cesau78/verminology/3d-models/liquid-bait-station/latest-builds/v2.8.1-prototype/stopper.stl

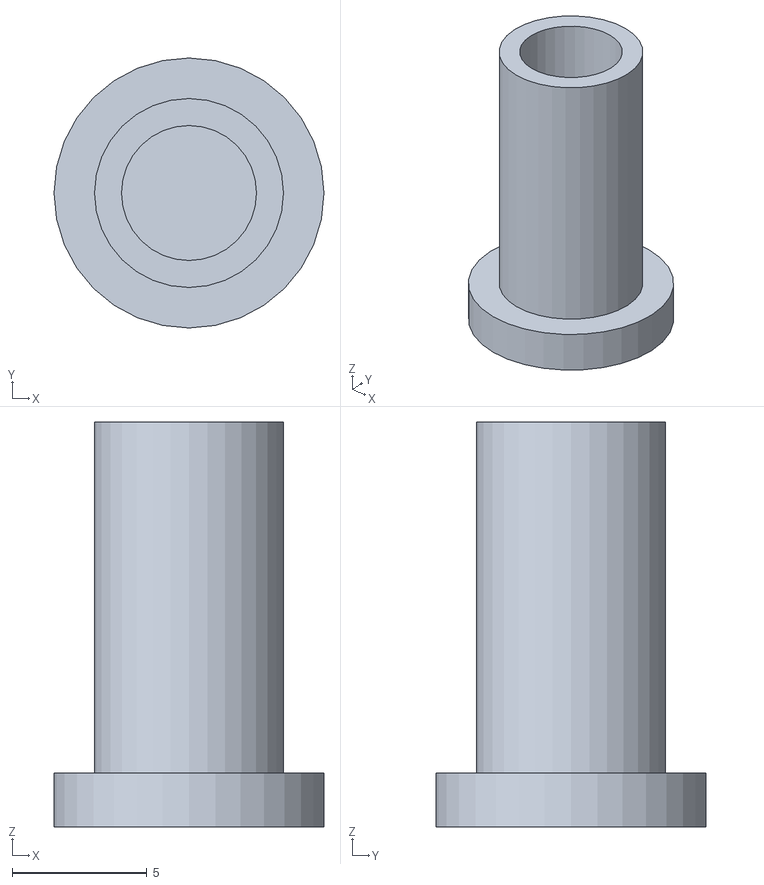
[picture p1: CAD file, 2026-07-14]
3d-models/liquid-bait-station/latest-builds/v2.8.1-prototype/stopper.stl
10.0 x 10.0 x 15.0
