cesau78/verminology/3d-models/liquid-bait-station/latest-builds/v2.8.1/station.stl

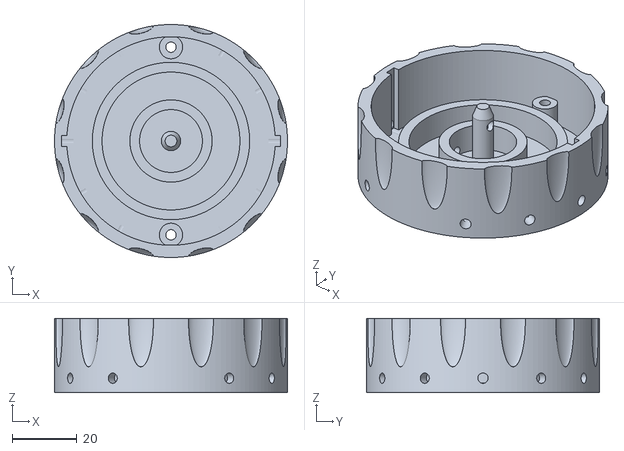
[picture p2: CAD file, 2026-07-15]
3d-models/liquid-bait-station/latest-builds/v2.8.1/station.stl
72.0 x 72.0 x 23.0
