cesau78/verminology/3d-models/liquid-bait-station/liquid-bait-station.stl

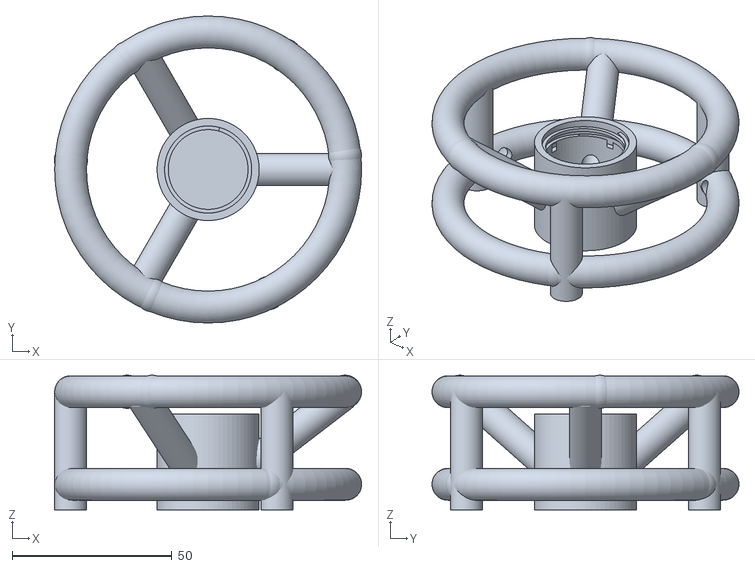
[picture p3: CAD file, 2026-02-25]
3d-models/liquid-bait-station/liquid-bait-station.stl
96.3 x 96.2 x 42.2
