cesau78/verminology/3d-models/liquid-bait-station/latest-builds/v2.8.1-prototype/grip.stl

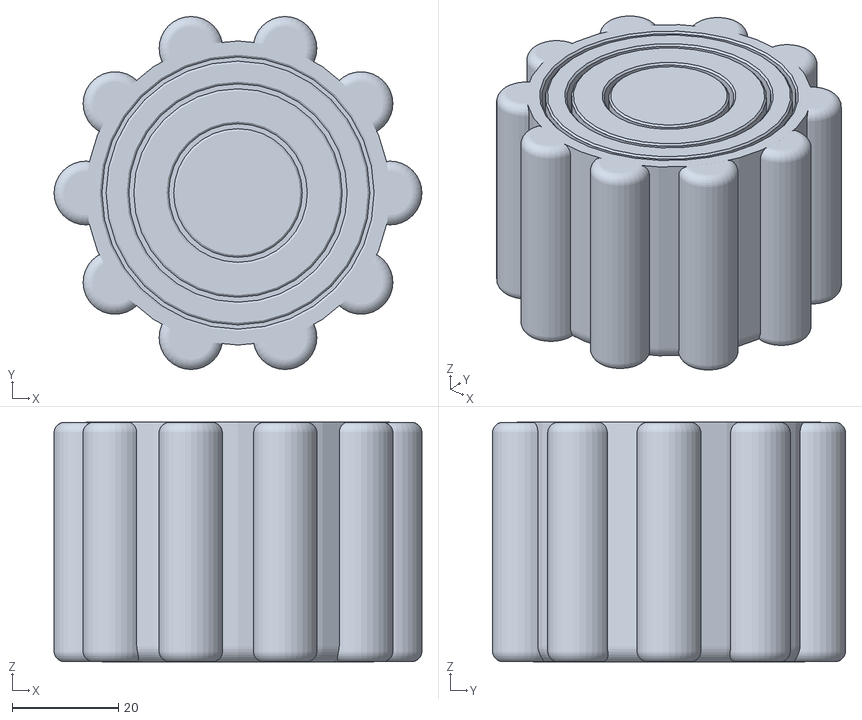
[picture p4: CAD file, 2026-07-14]
3d-models/liquid-bait-station/latest-builds/v2.8.1-prototype/grip.stl
69.1 x 66.3 x 45.0
