cesau78/verminology/3d-models/liquid-bait-station/latest-builds/v2.8.1/anvil.stl

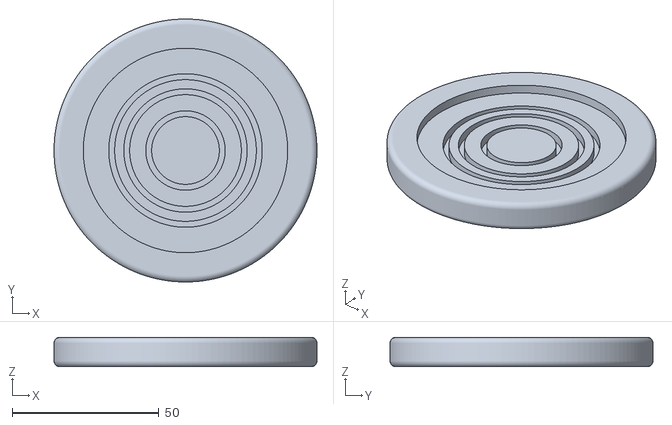
[picture p5: CAD file, 2026-07-15]
3d-models/liquid-bait-station/latest-builds/v2.8.1/anvil.stl
89.7 x 89.7 x 10.0
