cesau78/verminology/3d-models/liquid-bait-station/oring.stl

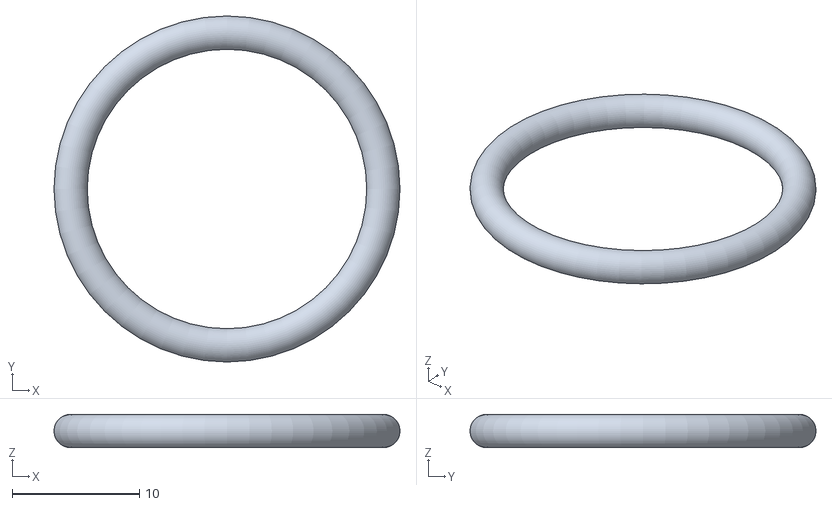
[picture p6: CAD file, 2026-02-25]
3d-models/liquid-bait-station/oring.stl
27.2 x 27.2 x 2.62
