cesau78/verminology/3d-models/liquid-bait-station/latest-builds/v2.8.1-prototype/needle-seal.stl

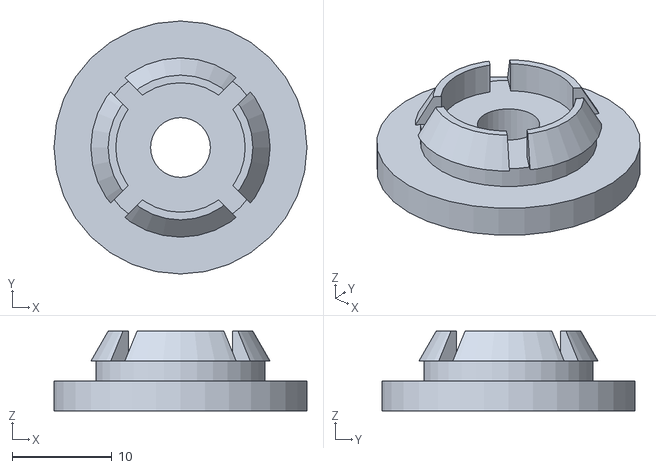
[picture p7: CAD file, 2026-07-14]
3d-models/liquid-bait-station/latest-builds/v2.8.1-prototype/needle-seal.stl
25.4 x 25.4 x 8.00
