cesau78/verminology/3d-models/liquid-bait-station/latest-builds/v2.8.1/seal-ring.stl

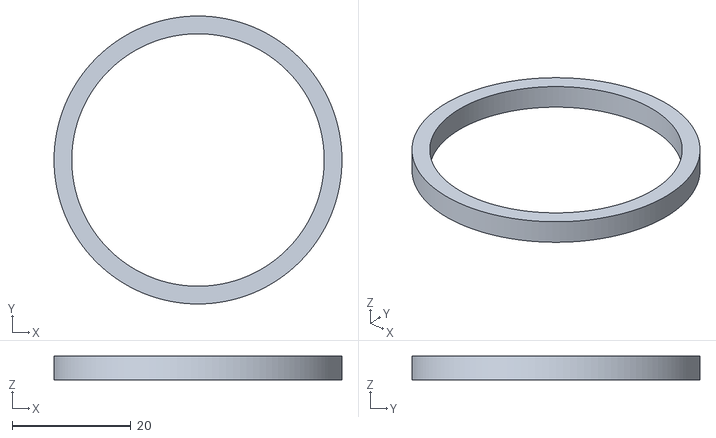
[picture p8: CAD file, 2026-07-15]
3d-models/liquid-bait-station/latest-builds/v2.8.1/seal-ring.stl
48.6 x 48.6 x 4.00
