cesau78/verminology/3d-models/liquid-bait-station/latest-builds/v2.8.1-prototype/reservoir.stl

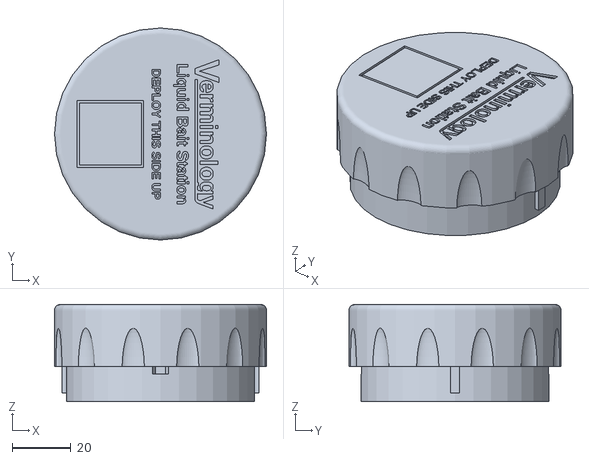
[picture p10: CAD file, 2026-07-14]
3d-models/liquid-bait-station/latest-builds/v2.8.1-prototype/reservoir.stl
72.0 x 72.0 x 33.0
