cesau78/verminology/3d-models/liquid-bait-station/latest-builds/v2.4.0-prototype/needle-seal.stl

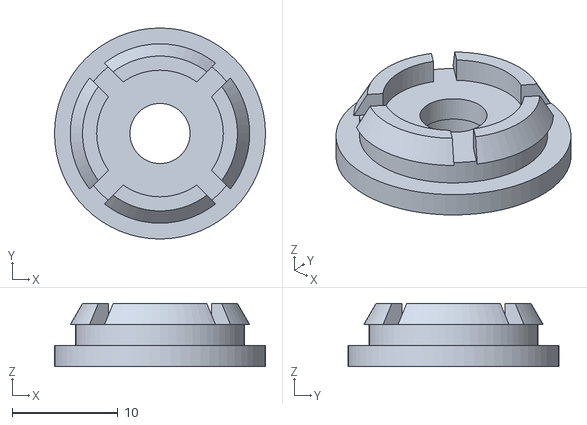
[picture p11: CAD file, 2026-04-04, an earlier design]
3d-models/liquid-bait-station/latest-builds/v2.4.0-prototype/needle-seal.stl
20.0 x 20.0 x 6.00
