cesau78/verminology/3d-models/liquid-bait-station/latest-builds/v2.4.1-prototype/needle-insert.stl

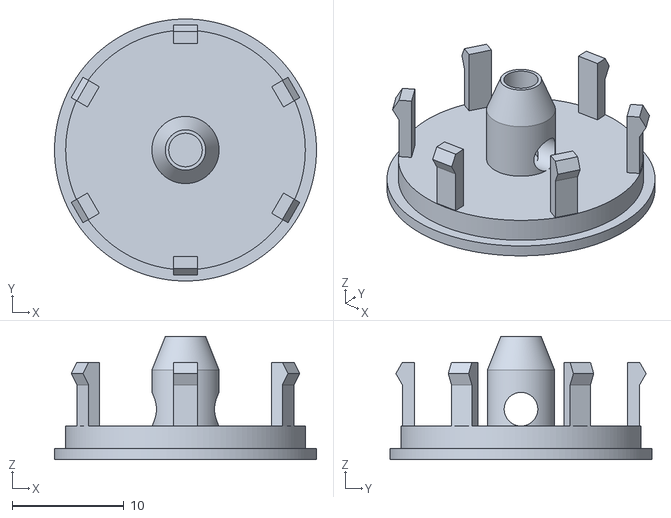
[picture p12: CAD file, 2026-04-04, an earlier design]
3d-models/liquid-bait-station/latest-builds/v2.4.1-prototype/needle-insert.stl
23.4 x 23.4 x 11.0
