cesau78/verminology/3d-models/liquid-bait-station/latest-builds/v2.5.0/station.stl

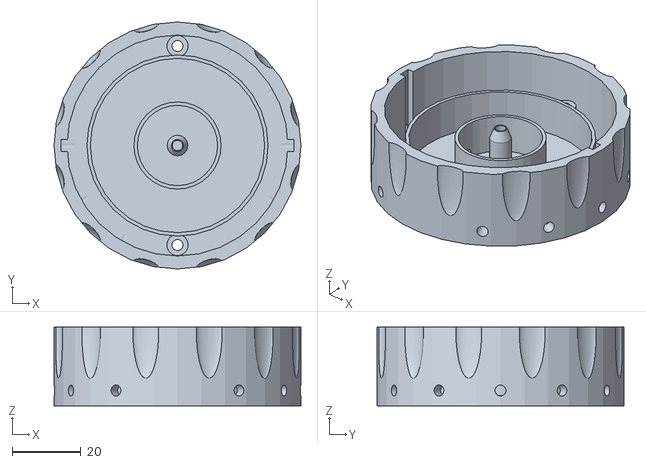
[picture p13: CAD file, 2026-04-09, an earlier design]
3d-models/liquid-bait-station/latest-builds/v2.5.0/station.stl
72.0 x 72.0 x 23.0
