cesau78/verminology/3d-models/liquid-bait-station/build-stamp.scad

// AUTO-GENERATED by scripts/Export-OpenScadStl.ps1 - do not edit by hand
// Source: build-config.json

info_stamp_line1 = "Verminology";
info_stamp_line2 = "Liquid Bait Station";
info_stamp_line3 = "v2.8.1 Prototype";
needle_seal_stamp_bottom = false;
seal_ring_stamp_bottom = false;
reservoir_stamp_bottom = true;
station_stamp_bottom = true;
stopper_stamp_bottom = false;
grip_stamp_bottom = false;
anvil_stamp_bottom = false;
