cesau78/verminology/3d-models/liquid-bait-station/v2-clam-shell/assembly.scad

// V2 Assembly View — All parts in operating position.
// Tray bait fill is the `show_batting` ring (assembly preview only — not a tread mesh). For prayer-sole tread + bracket preview see tektonology/3d-models/bumper-bracket/assembly.scad.
// Toggle 'locked' to see seated vs raised.
// Toggle 'exploded' to spread parts for inspection.

use <station.scad>
use <reservoir.scad>
use <needle-seal.scad>
use <seal-ring.scad>
use <stopper.scad>
include <common.scad>

// ── Settings ──────────────────────────────────────────────────────
exploded   = true;  // spread parts vertically for inspection
explode_gap = 2;    // mm half-offset each way when exploded (station −Z, cup +Z → 2× gap)
show_valve     = true;   // show the TPU needle seal (reservoir floor)
show_seal_ring = true;   // show the TPU barrier seal ring (reservoir bottom)
show_stopper   = true;   // show flow stopper + spring inside reservoir
show_batting   = true;   // show bait ring in tray (assembly preview only)
locked     = true;   // true = locked (pin engaged), false = unlocked (resting)

// Bait / batting — assembly depiction only (not a printed part)
batting_od_in = 2;
batting_id_in = 1;
batting_h_in  = 1 / 4;
batting_od    = batting_od_in * 25.4;
batting_id    = batting_id_in * 25.4;
batting_h     = batting_h_in * 25.4;

// ── Positions ─────────────────────────────────────────────────────
// Reservoir slides straight down; locked = fully seated, unlocked = raised.
// Exploded: reservoir stack +`explode_gap`, station/needle −`explode_gap` → 2× separation.
station_explode_z = exploded ? -explode_gap : 0;
res_z = locked
    ? reservoir_seat
    : reservoir_seat + 15;
res_z_final = res_z + (exploded ? explode_gap : 0);

// ── Valve position (shared by flange and disk) ──────────────────
valve_z = res_z_final - valve_flange_h;

// ── Stopper position ─────────────────────────────────────────────
// Locked: bottom face on needle tip (`pin_top` with station at z=0; follows `station_explode_z`).
// Unlocked: bottom ≈ reservoir outer bottom; +`explode_gap` when exploded with the cup.
stopper_z_final = locked
    ? pin_top + station_explode_z
    : res_z + (exploded ? explode_gap : 0);

// ── Assembly ──────────────────────────────────────────────────────
crosssection(station_od * 2) {
    // Station shell with integrated needle pin
    color("SlateGray", 0.8)
        translate([0, 0, station_explode_z])
            bait_station();

    // Bait ring on tray floor (visualization)
    if (show_batting)
        color("Peru", 0.9)
            translate([0, 0, station_floor + station_explode_z])
                difference() {
                    cylinder(h = batting_h, d = batting_od);
                    translate([0, 0, -0.02])
                        cylinder(h = batting_h + 0.04, d = batting_id);
                }

    // Reservoir — drops straight into station bore
    color("SteelBlue", 0.8)
        translate([0, 0, res_z_final])
            reservoir();

    // Needle seal — flange, disk, and retention ring
    if (show_valve)
        color("LimeGreen", 0.9)
            translate([0, 0, valve_z])
                needle_seal();

    // Barrier seal ring — TPU ring on reservoir bottom face
    if (show_seal_ring)
        color("LimeGreen", 0.9)
            translate([0, 0, res_z_final - seal_ring_protrusion])
                seal_ring();

    // Flow stopper piston
    if (show_stopper)
        color("OrangeRed", 0.9)
            translate([0, 0, stopper_z_final])
                stopper();

    // Compression spring (visualization cylinder)
    if (show_stopper) {
        _spr_bot = stopper_z_final + stopper_h - stopper_bore_depth;
        _spr_ceil = res_z_final + wall + spring_housing_bottom_clearance
                    + spring_housing_bore_h;
        _spr_h   = min(spring_height, _spr_ceil - _spr_bot);
        if (_spr_h > 0)
            color("Silver", 0.6)
                translate([0, 0, _spr_bot])
                    cylinder(h = _spr_h, d = spring_od);
    }
}
