cesau78/verminology/(list of files, cad)

Other CAD files:
3d-models/liquid-bait-station/latest-builds/v2.8.1-prototype/station.stl
3d-models/liquid-bait-station/latest-builds/v2.8.1/stopper.stl
3d-models/liquid-bait-station/latest-builds/v2.8.1-prototype/anvil.stl
3d-models/liquid-bait-station/latest-builds/v2.8.1-prototype/seal-ring.stl
3d-models/liquid-bait-station/latest-builds/v2.5.0-prototype/needle-seal.stl
3d-models/liquid-bait-station/stamp_generated.scad
3d-models/liquid-bait-station/latest-builds/v2.4.0-prototype/needle-gasket.stl
3d-models/liquid-bait-station/latest-builds/v2.4.0-prototype/needle-insert.stl
3d-models/liquid-bait-station/latest-builds/v2.4.1-prototype/needle-seal.stl
3d-models/liquid-bait-station/latest-builds/v2.5.0/needle-seal.stl
3d-models/liquid-bait-station/latest-builds/v2.5.1/needle-seal.stl
3d-models/liquid-bait-station/latest-builds/v2.5.2-prototype/needle-seal.stl
3d-models/liquid-bait-station/latest-builds/v2.5.2-prototype/reservoir.stl
3d-models/liquid-bait-station/latest-builds/v2.5.2-prototype/station.stl
3d-models/liquid-bait-station/latest-builds/v2.5.2/needle-seal.stl
3d-models/liquid-bait-station/latest-builds/v2.5.3-prototype/needle-seal.stl
3d-models/liquid-bait-station/latest-builds/v2.5.3-prototype/reservoir.stl
3d-models/liquid-bait-station/latest-builds/v2.5.3-prototype/station.stl
3d-models/liquid-bait-station/latest-builds/v2.5.3/needle-seal.stl
3d-models/liquid-bait-station/latest-builds/v2.6.0-prototype/anvil.stl
3d-models/liquid-bait-station/latest-builds/v2.6.0-prototype/grip.stl
3d-models/liquid-bait-station/latest-builds/v2.6.0-prototype/needle-seal.stl
3d-models/liquid-bait-station/latest-builds/v2.6.0-prototype/reservoir.stl
3d-models/liquid-bait-station/latest-builds/v2.6.0-prototype/station.stl
3d-models/liquid-bait-station/latest-builds/v2.6.0/needle-seal.stl
3d-models/liquid-bait-station/latest-builds/v2.7.0-prototype/anvil.stl
3d-models/liquid-bait-station/latest-builds/v2.7.0-prototype/grip.stl
3d-models/liquid-bait-station/latest-builds/v2.7.0-prototype/needle-seal.stl
3d-models/liquid-bait-station/latest-builds/v2.7.0-prototype/reservoir.stl
3d-models/liquid-bait-station/latest-builds/v2.7.0-prototype/station.stl
3d-models/liquid-bait-station/latest-builds/v2.7.0-prototype/stopper.stl
3d-models/liquid-bait-station/latest-builds/v2.7.0/anvil.stl
3d-models/liquid-bait-station/latest-builds/v2.7.0/needle-seal.stl
3d-models/liquid-bait-station/latest-builds/v2.7.0/stopper.stl
3d-models/liquid-bait-station/latest-builds/v2.7.1-prototype/anvil.stl
3d-models/liquid-bait-station/latest-builds/v2.7.1-prototype/grip.stl
3d-models/liquid-bait-station/latest-builds/v2.7.1-prototype/needle-seal.stl
3d-models/liquid-bait-station/latest-builds/v2.7.1-prototype/reservoir.stl
3d-models/liquid-bait-station/latest-builds/v2.7.1-prototype/station.stl
3d-models/liquid-bait-station/latest-builds/v2.7.1-prototype/stopper.stl
3d-models/liquid-bait-station/latest-builds/v2.7.1/needle-seal.stl
3d-models/liquid-bait-station/latest-builds/v2.7.1/stopper.stl
3d-models/liquid-bait-station/latest-builds/v2.7.2-prototype/anvil.stl
3d-models/liquid-bait-station/latest-builds/v2.7.2-prototype/grip.stl
3d-models/liquid-bait-station/latest-builds/v2.7.2-prototype/needle-seal.stl
3d-models/liquid-bait-station/latest-builds/v2.7.2-prototype/reservoir.stl
3d-models/liquid-bait-station/latest-builds/v2.7.2-prototype/station.stl
3d-models/liquid-bait-station/latest-builds/v2.7.2-prototype/stopper.stl
3d-models/liquid-bait-station/latest-builds/v2.7.3-prototype/anvil.stl
3d-models/liquid-bait-station/latest-builds/v2.7.3-prototype/grip.stl
3d-models/liquid-bait-station/latest-builds/v2.7.3-prototype/needle-seal.stl
3d-models/liquid-bait-station/latest-builds/v2.7.3-prototype/reservoir.stl
3d-models/liquid-bait-station/latest-builds/v2.7.3-prototype/station.stl
3d-models/liquid-bait-station/latest-builds/v2.7.3-prototype/stopper.stl
3d-models/liquid-bait-station/latest-builds/v2.7.3/needle-seal.stl
3d-models/liquid-bait-station/latest-builds/v2.7.3/stopper.stl
3d-models/liquid-bait-station/latest-builds/v2.8.0-prototype/anvil.stl
3d-models/liquid-bait-station/latest-builds/v2.8.0-prototype/grip.stl
3d-models/liquid-bait-station/latest-builds/v2.8.0-prototype/needle-seal.stl
3d-models/liquid-bait-station/latest-builds/v2.8.0-prototype/reservoir-000-e68430aa-ead2-47cb-a828-862537ad68ba-background.stl
3d-models/liquid-bait-station/latest-builds/v2.8.0-prototype/reservoir-000-e68430aa-ead2-47cb-a828-862537ad68ba-contrast.stl
3d-models/liquid-bait-station/latest-builds/v2.8.0-prototype/reservoir-text.stl
3d-models/liquid-bait-station/latest-builds/v2.8.0-prototype/reservoir.stl
3d-models/liquid-bait-station/latest-builds/v2.8.0-prototype/seal-ring.stl
3d-models/liquid-bait-station/latest-builds/v2.8.0-prototype/station-text.stl
3d-models/liquid-bait-station/latest-builds/v2.8.0-prototype/station.stl
3d-models/liquid-bait-station/latest-builds/v2.8.0-prototype/stopper.stl
3d-models/liquid-bait-station/latest-builds/v2.8.0/anvil.stl
3d-models/liquid-bait-station/latest-builds/v2.8.0/needle-seal.stl
3d-models/liquid-bait-station/latest-builds/v2.8.0/reservoir-text.stl
3d-models/liquid-bait-station/latest-builds/v2.8.0/seal-ring.stl
3d-models/liquid-bait-station/latest-builds/v2.8.0/station-text.stl
3d-models/liquid-bait-station/latest-builds/v2.8.0/station.stl
3d-models/liquid-bait-station/latest-builds/v2.8.0/stopper.stl
3d-models/liquid-bait-station/v1-double-torus/liquid-bait-station.scad
3d-models/liquid-bait-station/v1-double-torus/oring.scad
3d-models/liquid-bait-station/v2-slit-valve/reservoir.stl
3d-models/liquid-bait-station/v2-slit-valve/station.stl
