cesau78/verminology/3d-models/liquid-bait-station/latest-builds/v2.5.0/release-notes.md

# v2.5.0 — Production Build

**Date:** Apr 8, 2026

Production-quality STL export of v2.5.0 at `$fn = 128`. Same geometry as
`v2.5.0-prototype`; version stamp reads "v2.5.0" (no Prototype suffix).

See `../v2.5.0-prototype/release-notes.md` for full design changelog.

## Artifacts

| File | Part |
|---|---|
| `reservoir.stl` | Reservoir |
| `station.stl` | Station (bottom stamp: v2.5.0) |
| `needle-seal.stl` | TPU needle seal |
