cesau78/verminology/(commit log)

2026-02-23 added services and database - wip
    [liquid-bait-station.3mf, liquid-bait-station.scad]
2026-02-23 chore: update generated STL [skip ci]
2026-02-24 reversed thread direction
    [liquid-bait-station.scad]
2026-02-24 made core a little wider
    [liquid-bait-station.scad]
2026-02-24 reduced the number or arms to 3
    [liquid-bait-station.scad]
2026-02-24 back to prod
    [liquid-bait-station.scad]
2026-02-24 performance tuning
    [liquid-bait-station.scad]
2026-02-24 reversed threads, again. make a lead-in cut for the bottle insertion
    [liquid-bait-station.scad]
2026-02-24 preview off
    [liquid-bait-station.scad]
2026-02-25 threading adjustments and o-ring inclusing
    [liquid-bait-station.3mf, liquid-bait-station.scad, oring.scad]
2026-02-25 disconnected base height from torus height - increasd difference by 10mm
    [liquid-bait-station.scad]
2026-02-25 adjusted backstops and flows
    [liquid-bait-station.scad]
2026-02-25 adjusted rendering issue
    [liquid-bait-station.scad]
2026-02-25 adjusting backstop size
    [liquid-bait-station.scad]
2026-02-25 added circular groove for oring
    [liquid-bait-station.3mf, liquid-bait-station.scad, liquid-bait-station.stl]
2026-02-25 oring adjustments
    [liquid-bait-station.3mf, liquid-bait-station.scad, oring.scad]
2026-02-25 latest render
    [liquid-bait-station.3mf]
2026-02-26 lowered tube arm position on the reservoir, added a lip for the oring to rest on
    [liquid-bait-station.scad]
2026-02-27 fasten parts progress check-in
    [liquid-bait-station.3mf]
2026-03-30 reorganize liquid-bait-station into v1-double-torus and v2-multi-part
    [liquid-bait-station.3mf, liquid-bait-station.scad, oring.scad]
2026-03-31 add v2-slit-valve liquid bait station: rigid reservoir with push-pin activated TPU slit valve
    Replaces the v1 bottle-based design which failed due to flexible bottles causing
    uncontrolled fluid rush. V2 uses a rigid 3D-printed reservoir (~124ml) that drops
    into an open tray station with a bayonet ramp-lock. Twisting to lock pushes the
    reservoir onto a central conical pin that spreads a TPU cross-slit valve open.
    Unlocking raises the reservoir off the pin and the valve self-seals.
    [assembly.scad, common.scad, reservoir.scad, slit-valve.scad, station.scad]
2026-03-31 v2 station: add dual grooves, hump ring, ant tunnels, blunted pin
    Redesign the bait station tray with outer groove, hump torus, and inner
    groove for better bait distribution. Reservoir raised to sit above hump
    with half-pipe ant tunnels bridging over it. Guard holes reduced to 12
    at 3mm diameter. Push pin tip blunted for safety. Internal ribs replaced
    with radial struts that clear the valve bore.
    [assembly.scad, common.scad, reservoir.scad, station.scad]
2026-03-31 v2 slit valve: add flange stop collar, pin fluid channels, fix ant tunnels
    Slit valve gets a wider flange collar (2mm larger radius) that prevents
    push-through, with a snug sliding fit replacing the press-fit bore. Pin
    gains internal fluid channels (vertical + perpendicular at drain level).
    Ant tunnels trimmed to reservoir inner wall. Assembly exploded view now
    separates the valve between station and reservoir.
    [assembly.scad, common.scad, reservoir.scad, slit-valve.scad, station.scad]
2026-03-31 v2 slit valve: lower pin cone to flange top, shorten cone, tighten seal
    Pin cone now starts where the retention flange ends, reduced from 3mm
    to 2mm tall. Flange pin hole clearance tightened to 0.05mm radius for
    watertight TPU interference fit. Drain channels shortened to inner
    torus. Assembly view color-codes pin shaft, cone, retention ring, and
    slit valve disk. TPU plug z-position corrected by flange thickness.
    [assembly.scad, common.scad, slit-valve.scad, station.scad]
2026-03-31 v2 slit valve: add solid shipping plug for transport and storage
    Same flange and disk dimensions as the slit valve but with no slits,
    sealing the reservoir for filling, transport, and storage.
    [shipping-plug.scad]
2026-03-31 v2 reservoir: add self-supporting ceiling dome, fix strut-tunnel overlap
    Gentle 3mm spherical dome on interior ceiling eliminates need for
    supports or tree structures during FDM printing (~9° max overhang).
    Reordered CSG so ant tunnel cutouts apply after struts and dome,
    preventing struts from protruding into the underside channels.
    [common.scad, reservoir.scad]
2026-03-31 v2 reservoir: fix 2-manifold warning in ceiling dome
    Add tiny epsilon offsets to dome bounding cylinder to eliminate
    zero-thickness knife edge at cavity wall and coincident face
    with ceiling plane.
    [reservoir.scad]
2026-03-31 v2: fix coincident faces, regenerate STLs, add shipping plug STL
    Epsilon overlaps on struts, bayonet lugs, and ant tunnels eliminate
    all 2-manifold warnings. All four parts render Simple: yes.
    [reservoir.scad, reservoir.stl, shipping-plug.stl, slit-valve.stl, station.stl]
2026-04-01 v2: CW bayonet lock, flush skirt, valve retainer, remove dome
    - Bayonet lock: straight vertical entry + clockwise twist (righty-tighty)
    replaces counter-clockwise ramped descent
    - Reservoir skirt: outer cylinder extends reservoir to station OD for
    flush assembled profile
    - Slit valve retainer: top retention ring with tapered OD and flow slots
    snaps valve into reservoir bore
    - Remove ceiling dome (reservoir prints hole-up, dome unnecessary)
    - Guard holes increased to 3.2mm
    [assembly.scad, common.scad, reservoir.scad, slit-valve.scad, station.scad]
2026-04-01 v2 reservoir: cone ant tunnels, aligned struts, touching geometry
    - Ant tunnels changed from half-cylinders to half-cones spanning from
    reservoir wall to just outside valve retainer ring
    - Cone base sized so adjacent cones touch at the wall
    - Cone tip is 4mm diameter (flush with floor near retainer)
    - Strut count linked to tunnel count (12), centered with each cone
    [common.scad, reservoir.scad]
2026-04-01 modifications following the first print
    [assembly.scad, common.scad, liquid-bait-station.3mf, reservoir.3mf, reservoir.stl, slit-valve.scad, slit-valve.stl, station.stl]
2026-04-02 v2: shrink to 85mm for 3×3 on 256mm plate, shorten bayonet groove
    Reduce station OD from 90→85mm and reservoir OD from 82→77mm to fit
    9 parts per 256mm build plate (3×85=255mm) instead of 4. Volume drops
    from ~124ml to ~109ml. Also shorten bayonet lock rotation from 30° to
    5° so the groove only extends as far as the drop, matching lug travel.
    [common.scad, liquid-bait-station.3mf, station.stl]
2026-04-02 v2: add radial grip scallops to reservoir top and station bottom
    Radial spoke cylinders (r=5mm) from center, angled 15° down, cutting
    1mm into the top face at the rim corner for fingertip grip during
    bayonet twist. Station has mirrored scallops on the bottom face.
    [common.scad, reservoir.scad, station.scad]
2026-04-02 v2: add 1mm grip pad, apply scallops last
    Extra 1mm material on reservoir top and station bottom so scallops
    cut into solid padding rather than the functional surfaces. Restructure
    both assemblies so scallop subtraction is the outermost operation.
    [common.scad, reservoir.scad, station.scad]
2026-04-02 v2: widen grip scallop grooves to 9mm
    Increase scallop cylinder radius from 5 to 10.625 for 9mm wide
    grooves at the same 1mm cut depth.
    [common.scad]
2026-04-02 v2: Minkowski grip pads for rounded scallop ridges
    Replace simple extruded grip pads with Minkowski'd disks (thin
    cylinder + 0.5mm sphere). Scallops cut through the rounded pad so
    ridges between grooves inherit smooth edges instead of hard corners.
    [common.scad, reservoir.scad, station.scad]
2026-04-02 latest renders
    [reservoir.stl, station.stl]
2026-04-03 add .gitignore, stop tracking 3mf files
    3mf files are slicer project files that change frequently and
    bloat the repo. STL source files are still tracked.
    [liquid-bait-station.3mf, reservoir.3mf]
2026-04-03 v2: replace top/bottom grip scallops with oval side-wall indents
    Ellipsoid indents on the outer wall span the station/reservoir joint,
    with natural taper stopping smoothly before top and bottom floors.
    Reservoir scallops pre-rotated by bayonet_rotation so they align when
    locked. Bump $fn render to 256 for smoother cylinders.
    [assembly.scad, common.scad, reservoir.scad, station.scad]
2026-04-03 v2: side-wall oval grip scallops, edge fillets, re-render STLs
    Replace top/bottom radial grip scallops with ellipsoid indents on
    the outer wall spanning the station/reservoir joint. Reservoir
    scallops pre-rotated by bayonet_rotation for alignment when locked.
    Add 2mm quarter-round edge fillets on station bottom and reservoir
    top. Revert $fn render to 64 for prototype iteration speed.
    [common.scad, reservoir.scad, station.scad]
2026-04-03 v2: replace push pin cone with open straw for fluid flow
    Remove cone/blunt cap tip, make pin a straight hollow straw open at
    top. Widen internal bore to 3mm, add 3 cross-tunnels at 120° (was 2
    at 90°) for better drainage. Pin penetration set to 3mm past valve.
    [common.scad, station.scad]
2026-04-03 v2: add needle-seal valve — slit-free TPU seal with interference fit
    [common.scad, needle-seal.scad]
2026-04-03 v2: rename v2-slit-valve to v2-clam-shell
    [assembly.scad, common.scad, needle-seal.scad, reservoir.scad, shipping-plug.scad, shipping-plug.stl, slit-valve.scad, slit-valve.stl]
2026-04-03 v2: replace bayonet twist-lock with straight tab slide-lock
    [assembly.scad, common.scad, reservoir.scad, station.scad]
2026-04-03 v2: add retention clips with snap-fit barbs, remove bottom fillet, clean up assembly
    Curved clip arms on reservoir skirt slide into grooves on station outer
    wall. Diamond-shaped barbs at 30° ramp angle snap into notches at seated
    position. Guard holes at clip positions removed. Stale pin cone/shaft
    references removed from assembly.
    [assembly.scad, common.scad, reservoir.scad, station.scad]
2026-04-03 feat(liquid-bait-station): bottom stamp, export scripts, latest-build STLs
    - Add print-stamp-config.json, stamp_generated.scad, and PS1/bash export to latest-build
    - Station bottom deboss: three lines, rule to y tail, radial shift, mesh_preview rename
    - GitHub Actions workflow for stamp regen and STL export
    - Move tracked STLs into latest-build (rename-detected where matched)
    Made-with: Cursor
    [common.scad, needle-seal.stl, reservoir.scad, shipping-plug.stl, slit-valve.stl, stamp_generated.scad, station.scad]
2026-04-03 v2 clam-shell station: flat tray, barriers, pin bore, assembly bait
    - Flat 3mm floor; remove torus grooves/drains; 6mm tray gap under reservoir
    - Outer 2in ID + inner 1in OD barrier rings; six radial ports in inner wall
    - Single lateral pin channel through full OD; no holes through outer barrier
    - Pin tip height flush with needle seal disk (not retainer)
    - Assembly view: optional bait ring; batting visualization
    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
    [assembly.scad, common.scad, station.scad]
2026-04-03 v2 station: foil-piercing frustum on push pin tip
    Outer taper (3 mm) from pin_dia to pin_tip_od; straight bore through tip.
    pin_shank_h separates cylindrical shank from taper; tunable in common.scad.
    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
    [common.scad, station.scad]
2026-04-03 v2: unit_od_reduction for smaller footprint; tray and barriers restored
    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
    [common.scad]
2026-04-03 v2 clam-shell: needle insert, center lip, and inner guide rails
    Add needle-insert-lib (include-based) with coaxial pocket and preview/export
    entry points. Insert base OD matches the inner bait barrier hole ID; station
    subtracts a matching pocket.
    Add inner-barrier guide rails and center filler, unioned after the pocket so
    they stay in the model. Add a floor annulus lip under the hole with notches on
    the hole side between rails for clip clearance; preview highlights the lip in
    red. Rails extend one millimeter below the tray floor to meet the lip.
    Update common parameters, assembly include wiring, and print-stamp config for
    the needle-insert STL export.
    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
    [assembly.scad, common.scad, needle-insert-export.scad, needle-insert-lib.scad, needle-insert.scad, stamp_generated.scad, station.scad]
2026-04-03 v2 needle insert: OD groove gasket, insert OD clearance, previews
    - Insert base OD = inner barrier hole ID - 0.2 mm; center floor lip 1 mm inset
    - Circumferential groove on base OD (2 mm tall, 1 mm deep); toroidal TPU gasket part + export
    - pin_tunnel_z vs needle seal flange; assembly/subassembly show gasket
    - print-stamp-config: needle-gasket STL export
    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
    [assembly.scad, common.scad, needle-gasket-export.scad, needle-gasket.scad, needle-insert-lib.scad, needle-insert-subassembly.scad, station.scad]
2026-04-03 v2 station/needle: drop center lip, fix channels, rail offset
    - Remove center hole floor ring, notches, and related common params; drop red lip preview color
    - Inner barrier guide rails +1 mm Z (inner_barrier_rail_z_offset_mm)
    - Lateral bore ends at inner barrier hole ID; cap pin_tunnel_z so lateral clears base top; axial bore from lateral bottom
    - needle_insert_channels: vertical from pin_channel_z_bottom, not through bed
    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
    [common.scad, needle-insert-lib.scad, station.scad]
2026-04-03 Refine v2 needle insert base and TPU ring geometry
    - Model base as two stacked cylinders (bottom 1 mm at hole ID, top 2 mm at bottom OD minus 2 mm diameter).
    - Remove OD groove; optional retention clips gated by needle_insert_retention_clips_enabled.
    - TPU ring: relaxed inner/outer radii and assembly comments; gasket OD still referenced to hole ID offset.
    - Pocket uses largest base OD; subassembly and assembly comments updated.
    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
    [assembly.scad, common.scad, needle-gasket.scad, needle-insert-lib.scad, needle-insert-subassembly.scad]
2026-04-03 v2 clam-shell: needle clips on land, barb geometry, pocket cap, subassembly station
    - Add bait_station to needle-insert-subassembly with use/station.scad; crosssection uses station_od*2.
    - Six retention posts on gasket land (not lower ring); 2 mm top barb with two ramps at configurable slope (60° from horizontal).
    - Restore inner-barrier rail filler back plate (annulus land OD to barrier ID); fix mistaken filler logic that dropped it.
    - needle_insert_pocket: radius from max(body, land+barb)+c, capped inside inner bait barrier OD minus min wall so subtract does not erase the ring.
    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
    [common.scad, needle-insert-lib.scad, needle-insert-subassembly.scad, station.scad]
2026-04-03 v2 needle clips: stem trim, radial inset, barb drop
    - Shorten stem from step bottom (stem_bottom_trim_mm) for interference fit.
    - Shift whole post+barb inward (retention_radial_inset_mm); rename from barb-only inset.
    - Lower barb base 0.2 mm (top_barb_drop_mm); stem ends at barb base; pocket z_clip follows.
    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
    [common.scad, needle-insert-lib.scad]
2026-04-04 liquid-bait-station: latest-builds + versioned STLs, drop slit valve / shipping plug
    - Replace latest-build/ with latest-builds/v2.4.0/ for v2 STLs; add releases.md.
    - print-stamp-config: product_version v2.4.0; stl paths use {product_version} placeholder.
    - Export-OpenScadStl.ps1 + export-open-scad-stl.sh substitute {product_version} in output paths.
    - CI artifact: latest-builds/**/*.stl and **/*.md.
    - Remove obsolete slit-valve.scad, shipping-plug.scad; drop slit_* params from common; refresh comments (needle seal).
    - Remove legacy latest-build STLs (oring, slit-valve, shipping-plug); stamp_generated v2.4.0 Prototype.
    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
    [assembly.scad, common.scad, needle-gasket.stl, needle-insert.stl, needle-seal.scad, needle-seal.stl, reservoir.scad, shipping-plug.scad]
2026-04-04 liquid-bait-station: fn 128 mesh export, prototype vs production STL folders
    - common.scad: mesh export fn 64 -> 128 when mesh_preview=false.
    - Rename latest-builds/v2.4.0 -> v2.4.0-prototype; config uses {version_folder}.
    - Export scripts: default output ...-prototype and Prototype stamp from preview;
    LBS_PRODUCTION=1 -> latest-builds/<version>/ only, no Prototype stamp.
    - Add workflow_dispatch production STL workflow (verify_product_version optional).
    - Rename stamp-export workflow title to prototype; document in releases.md.
    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
    [common.scad, needle-gasket.stl, needle-insert.stl, needle-seal.stl]
2026-04-04 ci: fix liquid-bait-station validation for v2 assembly path
    Root liquid-bait-station.scad was removed; render v2-clam-shell/assembly.scad.
    Use mesh_preview=true for a fast smoke test; full STLs remain stamp-export workflows.
    Drop obsolete v1 oring step and auto-commit job (root *.stl layout).
    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
2026-04-04 ci: write validation STL into workspace for artifact upload
    Container job run steps use container /tmp; upload-artifact runs on the host
    and only sees the mounted workspace. Output under .ci-validation/ (gitignored).
    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
2026-04-04 ci: merge liquid-bait-station workflows into single build pipeline
    One job runs in order: prototype stamp+STL export, assembly validation, optional
    production export (dispatch only). Shared workspace keeps stamp_generated in sync.
    Remove stamp-export, validation, and production-stl workflows; update releases.md.
    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
2026-04-04 Align needle seal flange bore; shrink TPU gasket OD
    - Flange inner diameter matches disk (seal_hole_dia) for continuous ID.
    - Increase needle_insert_disk_od_clearance_dia to 0.4 mm to reduce gasket OD by 0.2 mm.
    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
    [common.scad, needle-seal.scad]
2026-04-04 chore(liquid-bait-station): v2.4.1 prototype stamp config and latest-builds
    - print-stamp-config: versioned latest-builds/{version_folder} exports, needle parts
    - Regenerate stamp_generated; update common.scad
    - Add latest-builds/v2.4.1-prototype STLs
    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
    [common.scad, needle-gasket.stl, needle-insert.stl, needle-seal.stl, stamp_generated.scad]
2026-04-07 v2 clam-shell: beef up retention clips, clip grooves, and bore-side bridges
    - Retention arms span full radial annulus (reservoir OD to station OD); larger barb and relaxed ramp.
    - Station: through-wall clip channel plus deeper bottom notch for snap; guide tabs unchanged.
    - Clip-only inward shelves from bore ID (2 mm into cavity) to tie lands; no bridges over guide slots.
    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
    [assembly.scad, common.scad, reservoir.scad, station.scad]
2026-04-07 v2 clam-shell: wall slots, bottom barbs, drop skirt clips
    - Remove reservoir retention clips, station clip grooves, and wall bridges; drill all guard holes; solid bore wall at former clip sites.
    - Parametric lower OD sleeve on reservoir; vertical inter-tab slots (4 mm land, 0.2 mm kerfs) through main wall below skirt.
    - Outward bottom barbs on land azimuth with matching bore pockets; barbs anchored at sleeve bottom (z0 = -extension).
    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
    [common.scad, reservoir.scad, station.scad]
2026-04-07 v2 clam-shell: barb channel/catch, land rib, guard-hole skip
    - Station: 1 mm bore channel + full-wall rectangular catch for bottom barbs; skip three guard holes at former clip azimuths.
    - Reservoir: 1 mm radial rib on vertical land (cube); barbs on rib outer face; smaller barb protrusion; land tangential width 4 mm.
    - Assembly preview tweaks if changed.
    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
    [assembly.scad, common.scad, reservoir.scad, station.scad]
2026-04-07 Liquid bait station: consolidate needle-insert into one SCAD file
    - Merge needle-insert-lib into needle-insert.scad; drop lib and export entry
    - Consumers set needle_insert_as_library before include to avoid double mesh
    - Point print-stamp-config at needle-insert.scad
    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
    [assembly.scad, common.scad, needle-gasket-export.scad, needle-gasket.scad, needle-insert-export.scad, needle-insert-lib.scad, needle-insert-subassembly.scad, needle-insert.scad]
2026-04-07 Liquid bait station v2.5.0: retention tab foot + V groove, stamp config
    Bump product_version to v2.5.0. Anchor inner-barrier retention tabs to the
    tray floor with a foot, vertical outer face at barrier OD, and symmetric
    inward-facing V aligned to clip barb height. Update common.scad tab params.
    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
    [common.scad, station.scad]
2026-04-07 Liquid bait station v2: inner rail disk after needle pocket, rail/disk flush tweak
    Move inner rail disk union after needle_insert_pocket so the pocket no longer
    erases it; add inner_barrier_inner_rail_disk_cut and optional red preview.
    Document pocket vs disk in needle-insert. Add inner_barrier_inner_rail_disk_inner_flush_mm for bore-side alignment.
    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
    [common.scad, needle-insert.scad, stamp_generated.scad, station.scad]
2026-04-07 Add v2.5.0 prototype STL exports (liquid bait station clam shell)
    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
    [needle-gasket.stl, needle-insert.stl, needle-seal.stl]
2026-04-08 Liquid bait station v2: threaded needle insert, bolt-lock security, taller station
    Replace snap-fit retention clips with coarse square threaded needle insert and recessed hex socket (requires printed key to remove).
    Replace screw-in reservoir connection with 2-tab slide-down guide and M3x20 vertical bolt lock: captive hex-pocket nuts on reservoir underside at 90/270 deg, station bosses with cap-head counterbore from below. Station height raised to 23 mm (tray gap 11 mm) so bolt tip is flush with nut pocket top. Bait barriers grow to fill the taller tray.
    Add debug_bolt visualisation to reservoir and assembly.
    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
    [assembly.scad, common.scad, needle-insert-key.scad, needle-insert.scad, reservoir.scad, station.scad]
2026-04-09 Integrate needle pin into station, remove separate insert/gasket parts
    Merge needle pin directly into station body — no separate insert,
    threads, hex socket, or TPU gasket. Remove needle-insert.scad,
    needle-insert-key.scad, needle-gasket.scad, needle-gasket-export.scad,
    needle-insert-subassembly.scad, and associated STL exports.
    Clean up common.scad: remove all insert/gasket parameters, keep pin
    geometry. Remove debug_bolt visualisation. Rotate product stamp 90 deg.
    Extend tab slot inward for clean bore intersection at low fn.
    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
    [assembly.scad, common.scad, needle-gasket-export.scad, needle-gasket.scad, needle-gasket.stl, needle-insert-key.scad, needle-insert-subassembly.scad, needle-insert.scad]
2026-04-09 Add v2.6.0 prototype STL exports (integrated needle pin, bolt lock)
    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
    [needle-seal.stl]
2026-04-09 build fixes
    [needle-seal.stl, stamp_generated.scad, station.stl]
2026-04-09 Add v2.5.1 prototype: fix bolt boss interference, widen needle seal flange
    - Raise reservoir bolt lock boss bottom to z=0 (flush with reservoir floor) so it no longer interferes with the bait barrier ring
    - Extend station bolt lock boss upward to meet new reservoir boss bottom
    - Widen needle seal flange OD to match inner bait barrier ID (23.4mm) for a snug nest fit inside the inner ring
    - Center version stamp on station bottom, increase font sizes by 1
    - Bump version to v2.5.1, export prototype STLs
    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
    [assembly.scad, common.scad, needle-seal.stl, reservoir.scad, stamp_generated.scad, station.scad]
2026-04-09 Rename build config and draft_mesh, per-version release notes
    - Rename print-stamp-config.json to build-config.json
    - Rename mesh_preview to draft_mesh in common.scad and export scripts
    - Replace single releases.md with per-version release-notes.md (v1.5.9 through v2.5.1)
    - Update CI workflow and script references
    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
    [common.scad, stamp_generated.scad]
2026-04-10 Add v2.5.2 prototype: fix bolt boss interference, beef up cap-head socket
    Station boss height reduced by reservoir_outer_wall_extension_below_mm (3mm)
    to clear the reservoir sleeve; boss OD increased 1mm for floor material around
    the cap-head counterbore. Rename preview/draft_mesh to prototype throughout
    (config, scripts, OpenSCAD). CI now runs production export on every push to
    main. Promote v2.5.1 prototype to production.
    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
    [common.scad, needle-seal.stl, reservoir.stl, stamp_generated.scad, station.scad, station.stl]
2026-04-10 v2.5.3: seal nut pocket leak, auto-commit production builds
    Add 45deg seal prism atop each bolt-lock boss so the hex nut pocket no longer opens into the fluid cavity. Update CI workflow to commit and push production STLs after export (with [skip ci] to prevent re-trigger). Include v2.5.2 production STLs.
    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
    [needle-seal.stl, reservoir.scad]
2026-04-10 Pre-commit hook, rename build-stamp, tighten nut pocket
    Add .githooks/pre-commit to run prototype STL export locally on each commit. Rename stamp_generated.scad to build-stamp.scad. CI commit step now only pushes production STL folder. Reduce bolt_lock_nut_af from 5.8 to 5.6mm (0.05mm/side clearance, 0.39mm corner retention).
    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
    [build-stamp.scad, common.scad, needle-seal.stl, reservoir.stl, station.stl]
2026-04-10 build: production STLs for v2.5.3 [skip ci]
    [needle-seal.stl]
2026-04-17 v2.6.0: add substrate cutter tools (grip + anvil)
    Steel-rule die cutter for punching substrate discs. Finger-ribbed
    grip holds two concentric rule rings; matching anvil with registration
    pocket and relief channels receives the cutting force.
    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
    [anvil.scad, anvil.stl, assembly.scad, build-stamp.scad, common.scad, grip.scad, grip.stl, needle-seal.stl]
2026-04-17 build: production STLs for v2.6.0 [skip ci]
    [anvil.stl, needle-seal.stl]
2026-04-25 liquid-bait v2: tune inner barrier and TPU valve seal
    - Shorter inner bait barrier, thicker wall, valve flange + interference
    - crosssection_view on, explode gap 0 for assembly preview
    - Use inner_bait_barrier_h in station inner ring geometry
    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
    [anvil.stl, assembly.scad, common.scad, grip.stl, needle-seal.stl, reservoir.stl, station.scad, station.stl]
2026-04-25 liquid-bait v2: match inner barrier and flange to 1 in, 0.2 mm Z overlap
    - inner_bait barrier OD 1 in; id from wall; valve_flange_od = barrier OD
    - inner_bait_valve_squeeze_z 0.2 mm: h_reduction = valve_flange_h minus squeeze
    - Shorter inner ring for TPU stack (skip STL rebuild; --no-verify)
    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
    [common.scad]
2026-04-25 v2.7.0: add spring-loaded flow stopper to reservoir
    New flow-stop mechanism prevents fluid leaking when the reservoir is removed from the station. A compression spring pushes a stopper piston into the needle seal bore; the station needle pushes it back to open flow through a new perpendicular side port.
    - New part: stopper (7mm OD, 10mm tall, 5mm spring bore)
    - Reservoir: spring housing tube hangs from ceiling
    - Station needle: 6mm longer, axial channel capped, perpendicular flow hole aligned to bottom of 3rd seal ring
    - Assembly: stopper + spring visualization added
    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
    [anvil.stl, assembly.scad, build-stamp.scad, common.scad, grip.stl, needle-seal.stl, reservoir.scad, reservoir.stl]
2026-04-25 build: production STLs for v2.7.0 [skip ci]
    [anvil.stl, needle-seal.stl, stopper.stl]
2026-04-26 Liquid bait station v2.7.1 prototype: needle seal 0.2mm diametral fit, build artifacts
    - Ease TPU seal on 6mm pin: seal_hole_dia = pin_dia - 0.2 (5.8mm bore).
    - build-config v2.7.1; export order starts with needle-seal; regenerate stamp.
    - Add latest-builds/v2.7.1-prototype STLs and release notes.
    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
    [anvil.stl, build-stamp.scad, common.scad, grip.stl, needle-seal.stl, reservoir.stl, station.stl, stopper.stl]
2026-04-26 build: production STLs for v2.7.1 [skip ci]
    [anvil.stl, needle-seal.stl, stopper.stl]
2026-04-29 increased needle seal hole diameter by 0.1, leaving 0.1 diametrical interference with the needle
    [anvil.stl, build-stamp.scad, common.scad, grip.stl, needle-seal.stl, reservoir.stl, station.stl, stopper.stl]
2026-04-29 Liquid Bait Station v2.7.3 prototype: 17 mm valve bore
    - Widen reservoir floor bore (valve_disk_od 16 -> 17 mm) for easier test-tube insertion
    - Match seal bore to pin OD (seal_hole_dia)
    - Export STL set to latest-builds/v2.7.3-prototype/
    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
    [anvil.stl, build-stamp.scad, common.scad, grip.stl, needle-seal.stl, reservoir.stl, station.stl, stopper.stl]
2026-04-29 build: production STLs for v2.7.3 [skip ci]
    [anvil.stl, needle-seal.stl, stopper.stl]
2026-04-30 Liquid Bait Station v2.7.3: stopper collar, spring housing Z, assembly explode
    - Stopper: 7 mm shank in housing, 10 mm bottom disk, 15 mm total height, 13 mm spring bore depth.
    - Spring housing: rim flush with collar when locked; bottom clearance derived from pin_top for consistent Z.
    - Assembly: symmetric exploded view (station −Z, cup +Z) with stopper tracking needle and reservoir.
    - Regenerate latest-builds/v2.7.3-prototype STLs.
    [anvil.stl, assembly.scad, common.scad, grip.stl, needle-seal.stl, reservoir.stl, station.stl, stopper.scad]
2026-05-10 Liquid Bait Station v2.8.0: labyrinth tubes and barrier seal ring
    Replace conical ant tunnels and internal struts with R-shaped labyrinth tubes that route ants through sealed passages in the reservoir cavity. Liquid must flow uphill to escape, preventing leaks at tilt angles.
    Add TPU seal ring (press-fit into reservoir floor groove) that compresses against the outer bait barrier wall, sealing dry ant-access side from wet feeding area. Both barrier walls standardized to 3 mm radial thickness and matched height.
    [anvil.stl, assembly.scad, build-stamp.scad, common.scad, grip.stl, needle-seal.stl, reservoir.scad, reservoir.stl]
2026-05-10 Liquid Bait Station v2.9.0: spill reservoir, V-tube labyrinth, hull clip
    Add spill reservoir (pizza-wedge compartments around spring housing) to catch liquid when inverted. Replace R-shaped labyrinth with V-tube path plus separate straight feeding tube into spill reservoir. Add hull clip subtraction to trim sphere extensions from feeding area and compartment interiors. Flatten reservoir() boolean nesting. Move V leg 1 start flush with cavity ceiling.
    [anvil.stl, common.scad, grip.stl, needle-seal.stl, reservoir.scad, reservoir.stl, seal-ring.stl, station.stl]
2026-05-10 Liquid Bait Station v2.9.1: floor ribs, spring socket, cleanup
    Add full-height V-profile floor ribs (12x, interleaved with labyrinth tubes) for bridge support when printing upside down. Add twist-in spring retention socket at bore ceiling to prevent plunger fallout when inverted. Remove unused labyrinth_inner_top_z parameter.
    [anvil.stl, common.scad, grip.stl, needle-seal.stl, reservoir.scad, reservoir.stl, seal-ring.stl, station.stl]
2026-05-10 Liquid Bait Station: oversized V brand logo with repositioned underline
    Split brand stamp Verminology into oversized V initial + erminology rest, matching Tektonology logo treatment. Underline starts under the e, bottom flush with y descender. Tunable size, drop, cap/descent ratios.
    [anvil.stl, common.scad, grip.stl, needle-seal.stl, reservoir.stl, seal-ring.stl, station.stl, stopper.stl]
2026-05-10 Liquid Bait Station: orientation label, stamp layout tuning
    Add DEPLOY THIS SIDE DOWN label at bottom of station face. Shift product stamp block up so version line bottom is at disc center. Separate tertiary font size for version line (3mm). Tune brand centering with initial advance factor and manual X offset.
    [anvil.stl, common.scad, grip.stl, needle-seal.stl, reservoir.stl, seal-ring.stl, station.stl, stopper.stl]
2026-05-10 Liquid Bait Station: add station-text inlay for multi-color printing
    New station-text.scad generates the same text geometry as the station bottom deboss (brand, underline, product, version, orientation label) as a thin solid piece. Print in a contrasting color and press-fit into the debossed pockets.
    [anvil.stl, grip.stl, needle-seal.stl, reservoir.stl, seal-ring.stl, station-text.scad, station.stl, stopper.stl]
2026-05-10 build: production STLs for v2.8.0 [skip ci]
    [anvil.stl, needle-seal.stl, seal-ring.stl, station.stl, stopper.stl]
2026-05-12 liquid-bait-station: QR inlays, text exports, build scripts
    - Vendored scadqr (lib/qr.scad) and reservoir-qr.scad for background vs contrast STLs, positioned in top pocket; fix qr_half overwrite so exports differ.
    - build-config: qr_tag paths with seq/uuid; exports for station-text and reservoir-text.
    - Scripts: -QrTag/--qr-tag modes, qr_half in build-stamp, sequence scan; bash write_stamp half arg.
    - common/reservoir: QR pocket, stamp orient override, smaller tag and layout.
    - Regenerated prototype STLs including reservoir-text and station-text.
    [anvil.stl, build-stamp.scad, common.scad, grip.stl, needle-seal.stl, reservoir-000-e68430aa-ead2-47cb-a828-862537ad68ba-background.stl, reservoir-000-e68430aa-ead2-47cb-a828-862537ad68ba-contrast.stl, reservoir-qr.scad]
2026-05-17 Seal ring: flat annulus without labyrinth notches.
    The TPU ring press-fits the reservoir groove and seals the barrier continuously; labyrinth tubes stay on the reservoir only.
    [anvil.stl, grip.stl, needle-seal.stl, reservoir.stl, seal-ring.scad, seal-ring.stl, station.stl, stopper.stl]
2026-05-17 Clarify assembly preview: tray bait ring vs tread mesh.
    Document that show_batting is assembly-only bait fill and point to tektonology bumper-bracket assembly for tread preview.
    [anvil.stl, assembly.scad, grip.stl, needle-seal.stl, reservoir.stl, seal-ring.stl, station.stl, stopper.stl]
2026-05-17 Skip prototype STL rebuild when only assembly previews change.
    assembly.scad files are not exported; committing them alone should not rerun the full OpenSCAD export.
2026-05-21 Add middle steel-rule ring slot to substrate cutter tools.
    [anvil.scad, anvil.stl, assembly.scad, common.scad, grip.scad, grip.stl, needle-seal.stl, reservoir.stl]
2026-07-14 Liquid Bait Station v2.8.1: QR sticker frame, two-color layer text
    Replace the warp-prone QR pocket on the reservoir top with a thin
    engraved sticker outline frame, and switch text coloring from separate
    inlay STLs to slicer layer color changes (white band behind the deboss
    floor). Removes the printed QR tag pipeline and text inlay exports.
    [anvil.stl, build-stamp.scad, common.scad, grip.stl, needle-seal.stl, reservoir-qr.scad, reservoir-text.scad, reservoir.scad]
2026-07-15 build: production STLs for v2.8.1 [skip ci]
    [anvil.stl, needle-seal.stl, seal-ring.stl, station.stl, stopper.stl]
